Ryetechv1/ir-filter-spectrum-console/hardware/pcb/iphone16e_2s_sk6812_two_board_v0_8/DRC_STATUS.md

# DRC Status

This v0.8 PCB package was regenerated and checked with KiCad 10.

Current generated DRC status after `kicad-cli pcb drc`:

- Main controller carrier: 0 violations; 0 unconnected items.
- LED/camera head: 0 violations; 0 unconnected items.

Use the `*_GERBERS_DRC_CLEAN.zip` files for fabrication upload. Still print the board outlines at 1:1 and verify the mechanical fit in the phone case before ordering.
