Ryetechv1/ir-filter-spectrum-console/PUBLICATION.md

# Official GitHub Publication

**Project:** SW's Spectral Image Studio  
**Canonical repository:** https://github.com/Ryetechv1/ir-filter-spectrum-console  
**Published app:** https://ryetechv1.github.io/ir-filter-spectrum-console/?studio=camera&v=official-publication-2026-08-15  
**Publication page:** https://ryetechv1.github.io/ir-filter-spectrum-console/publication.html  
**Release tag:** `official-publication-2026-08-15`

This publication marks the current GitHub Pages build as the official public reference point for the browser-based spectral imaging studio. It includes the camera studio, effect presets, generated-value engine, overlay/media workflows, PRIME examples gallery, DWT isolation package, spatial recognition mesh/voxel controls, and related documentation.

## Citation

If results created with this project are shared or referenced, cite:

> Seth M. Knudson. **SW's Spectral Image Studio**. GitHub, 2026. https://github.com/Ryetechv1/ir-filter-spectrum-console

The machine-readable citation metadata is available in `CITATION.cff`.

## Rights

The project is published publicly through GitHub Pages for access and reference. All original app content, branding, gallery material, and generated publication wording are reserved to Seth M. Knudson / Supernatural World unless a separate written license is later added.

## Verification Checklist

- GitHub repository: `Ryetechv1/ir-filter-spectrum-console`
- GitHub Pages source: `docs/`
- Published app route: `/ir-filter-spectrum-console/?studio=camera`
- Citation metadata: `CITATION.cff`
- Official release tag: `official-publication-2026-08-15`
