Ryetechv1/ir-filter-spectrum-console/hardware/pcb/iphone16e_2s_sk6812_two_board_v0_4/gerbers_esp32_cam_led_head_v0_4/esp32_cam_led_head_v0_4_drill_report.txt

Drill report for esp32_cam_led_head_v0_4.kicad_pcb
Created on 2026-07-30T06:09:37

Copper Layer Stackup:
    =============================================================
    L1 :  F.Cu                      front
    L2 :  B.Cu                      back

Drill file 'esp32_cam_led_head_v0_4-PTH.drl' contains
    plated through holes:
    =============================================================
    T1  0.400mm  0.0157"  (7 holes))
    T2  0.900mm  0.0354"  (12 holes))

    Total plated holes count 19

Drill file 'esp32_cam_led_head_v0_4-NPTH.drl' contains
    unplated through holes:
    =============================================================

    Total unplated holes count 0
