Ryetechv1/ir-filter-spectrum-console/hardware/pcb/iphone16e_2s_sk6812_two_board_v0_4/gerbers_iphone16e_2s_sk6812_main_v0_4/iphone16e_2s_sk6812_main_v0_4_drill_report.txt

Drill report for iphone16e_2s_sk6812_main_v0_4.kicad_pcb
Created on 2026-07-30T06:09:34

Copper Layer Stackup:
    =============================================================
    L1 :  F.Cu                      front
    L2 :  B.Cu                      back

Drill file 'iphone16e_2s_sk6812_main_v0_4-PTH.drl' contains
    plated through holes:
    =============================================================
    T1  0.400mm  0.0157"  (24 holes))
    T2  1.000mm  0.0394"  (52 holes))
    T3  1.500mm  0.0591"  (6 holes))
    T4  2.000mm  0.0787"  (2 holes))

    Total plated holes count 84

Drill file 'iphone16e_2s_sk6812_main_v0_4-NPTH.drl' contains
    unplated through holes:
    =============================================================
    T1  3.200mm  0.1260"  (3 holes))

    Total unplated holes count 3
