Ryetechv1/ir-filter-spectrum-console/design/esp32-cam-ir-uva-console-concept.png

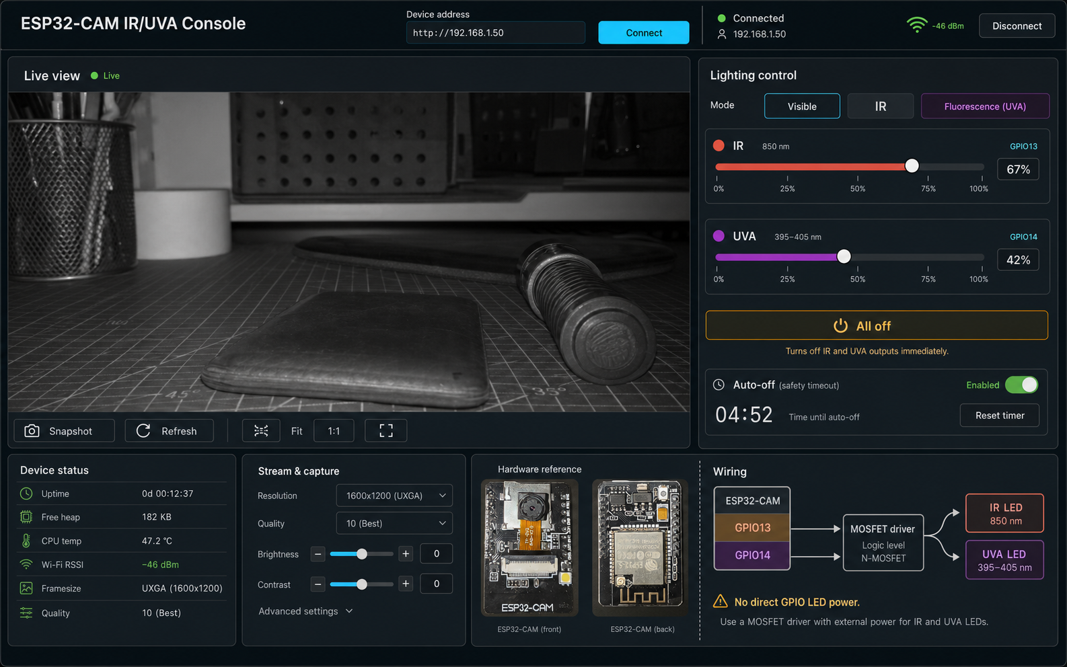
design/esp32-cam-ir-uva-console-concept.png
