Ryetechv1/ir-filter-spectrum-console/integrations/dwt_isolate_pipeline/exports/comparison_matrix_plot.png

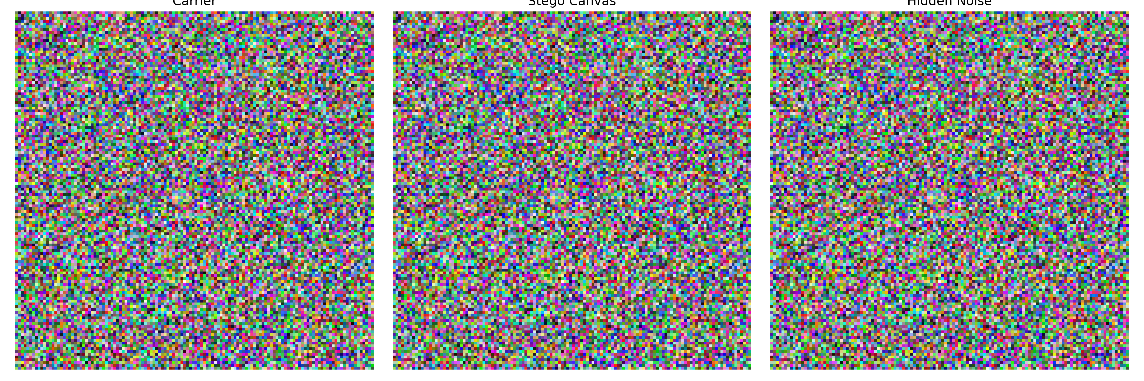
integrations/dwt_isolate_pipeline/exports/comparison_matrix_plot.png
