Ryetechv1/ir-filter-spectrum-console/integrations/dwt_isolate_pipeline/exports/export_extracted_hidden_noise.png

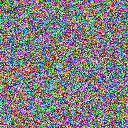
integrations/dwt_isolate_pipeline/exports/export_extracted_hidden_noise.png
