Ryetechv1/ir-filter-spectrum-console/hardware/pcb/iphone16e_2s_sk6812_two_board_v0_8/README_ORDERING.md

# iPhone 16e 2S SK6812 Two-Board PCB v0.8

This package contains two separate 2-layer KiCad PCB designs:

- Main controller carrier: `iphone16e_2s_sk6812_main_v0_8.kicad_pcb`
- Compact LED/camera head: `esp32_cam_led_head_v0_8.kicad_pcb`

The included v0.8 Gerber zip packages were regenerated with KiCad 10 and checked with DRC.

## What Changed From v0.7

- Added six SK6812 5 mm RGBW LEDs to the LED/camera head board for three independently controlled acrylic-square zones.
- Each acrylic zone has one left-edge LED and one right-edge LED driven as a mirrored pair from one webapp RGBW control.
- Expanded the head board to 50 mm x 90 mm while keeping it inside the 58 mm camera chamber envelope.
- Kept the same 14-pin JST-GH 1.25 mm locking wire-harness connector and the same single SK6812 data line.

## Power Compatibility

This is still optimized for the selected OVONIC 2S 7.4V 450mAh LiPo pack.

Use a proper 2S/8.4V USB-C LiPo charger/BMS plus a 2S-to-5V buck regulator rated 1A minimum, 2A preferred.

Do not use the 3S/12.6V Adeept charger module with this 2S battery.

## Suggested Fab Settings

- 2 layers for each board
- FR-4, 1.6 mm for the main board
- FR-4, 0.8 mm or 1.0 mm recommended for the LED head if your shell needs a lower profile
- 1 oz copper acceptable for this low-current LED version, 2 oz preferred
- Lead-free HASL or ENIG

## Important Assembly Checks

- Verify JST-GH harness pin 1 to pin 1 before powering the boards. Use a straight-through 14-conductor crimped harness.
- Verify the SK6812 5 mm RGBW LED pinout from your exact vendor before PCBA ordering. The generated footprint maps pin 1 to +5V, pin 2 to DIN, pin 3 to GND, and pin 4 to DOUT.
- The SK6812 chain order is RGBW 1 camera right, RGBW 2 camera left, Acrylic 1 left, Acrylic 1 right, Acrylic 2 left, Acrylic 2 right, Acrylic 3 left, Acrylic 3 right.
- Print both PCB outlines at 1:1 and test-fit them in the Speck case and printed shell before ordering.
- UVA and IR are eye hazards. Use shielding and UV-rated eye protection.
