Ryetechv1/ir-filter-spectrum-console/hardware/cad/iphone16e_housing_v0_1/stl/02_main_board_retainer.stl

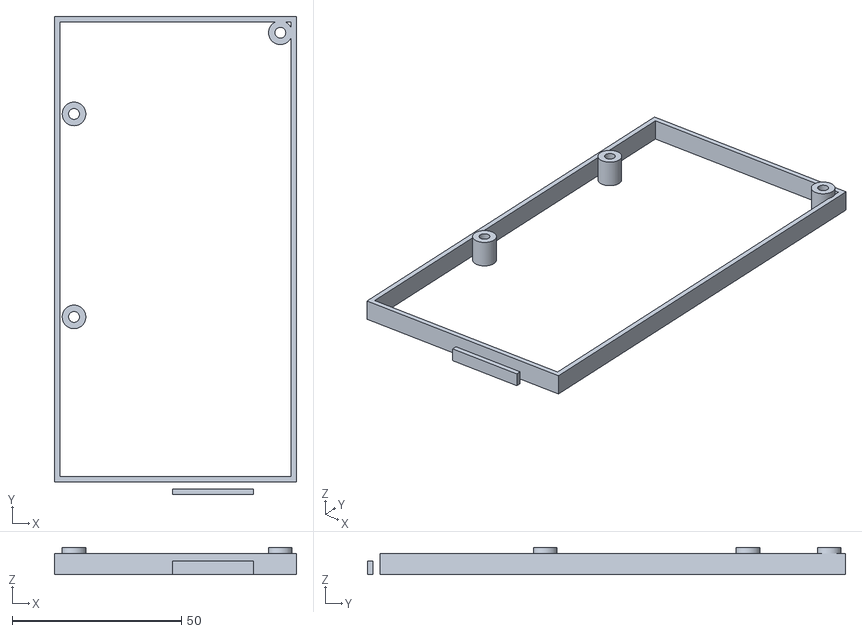
[picture p19: CAD file, 2026-08-01]
hardware/cad/iphone16e_housing_v0_1/stl/02_main_board_retainer.stl
71.6 x 141.3 x 8.00
