Ryetechv1/ir-filter-spectrum-console/hardware/cad/iphone16e_housing_v0_1/stl/08_acrylic_square_1_template.stl

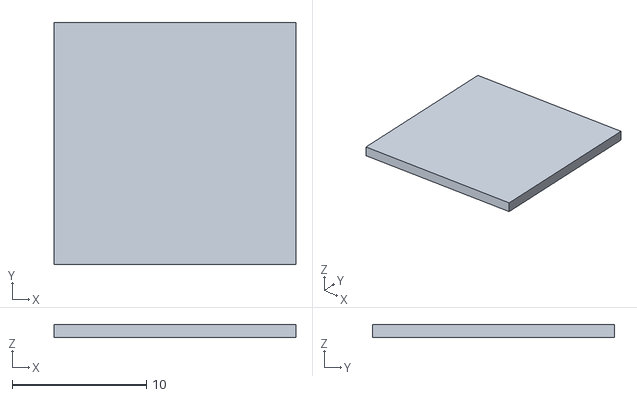
[picture p20: CAD file, 2026-08-01]
hardware/cad/iphone16e_housing_v0_1/stl/08_acrylic_square_1_template.stl
18.0 x 18.0 x 1.00
