Ryetechv1/ir-filter-spectrum-console/hardware/cad/iphone16e_housing_v0_1/stl/01_phone_back_sled.stl

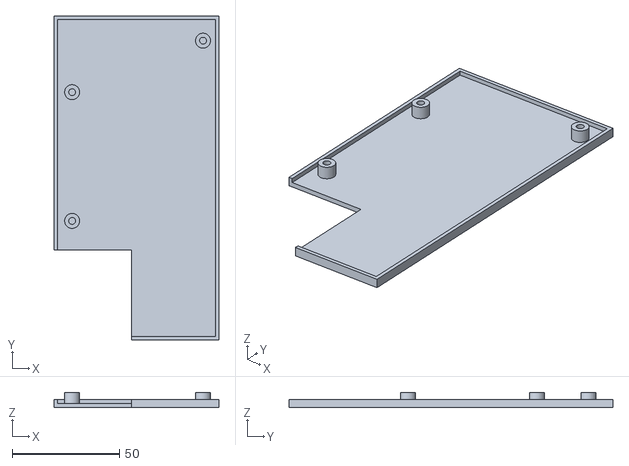
[picture p21: CAD file, 2026-08-01]
hardware/cad/iphone16e_housing_v0_1/stl/01_phone_back_sled.stl
76.8 x 151.0 x 7.20
