Ryetechv1/ir-filter-spectrum-console/hardware/cad/iphone16e_housing_v0_1/stl/06_clear_acrylic_lens_panel_template.stl

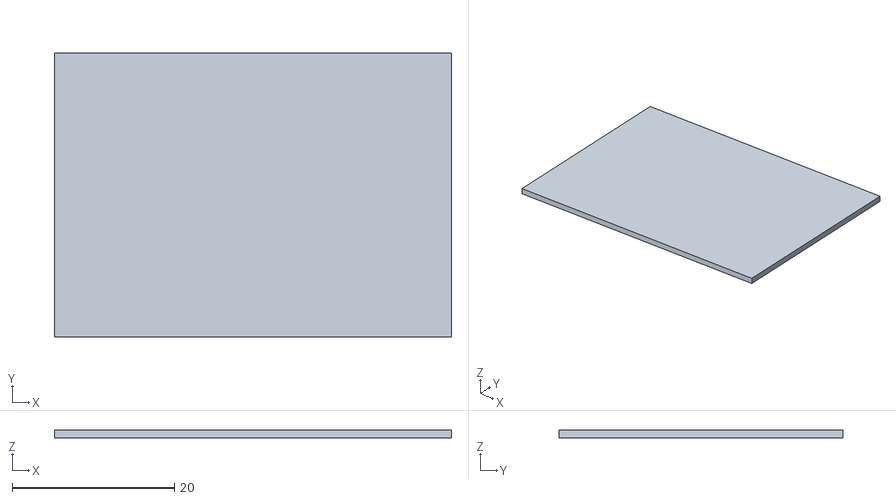
[picture p22: CAD file, 2026-08-01]
hardware/cad/iphone16e_housing_v0_1/stl/06_clear_acrylic_lens_panel_template.stl
49.0 x 35.0 x 1.00
