Ryetechv1/ir-filter-spectrum-console/hardware/cad/iphone16e_housing_v0_1/stl/03_ovonic_2s_battery_cradle.stl

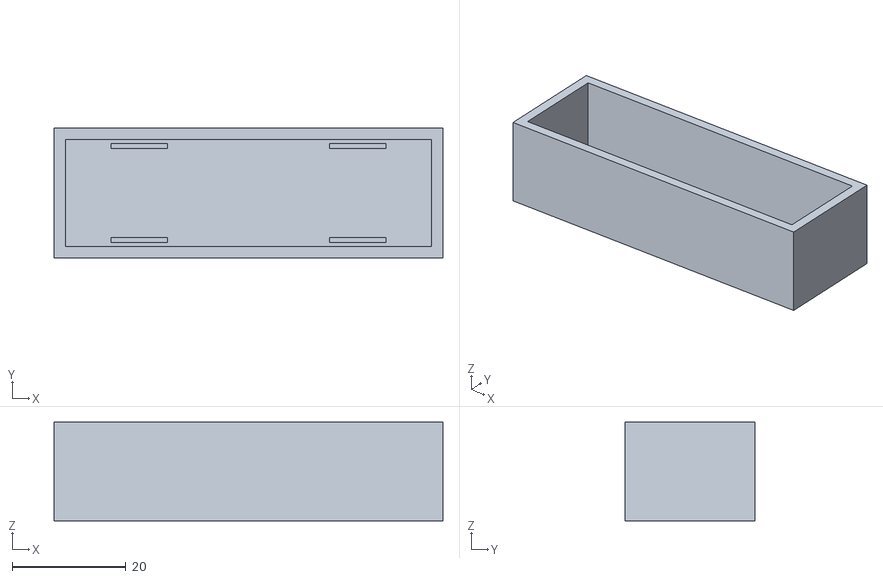
[picture p23: CAD file, 2026-08-01]
hardware/cad/iphone16e_housing_v0_1/stl/03_ovonic_2s_battery_cradle.stl
68.5 x 22.9 x 17.4
