Ryetechv1/ir-filter-spectrum-console/hardware/cad/iphone16e_housing_v0_1/stl/04_head_board_camera_effect_chamber.stl

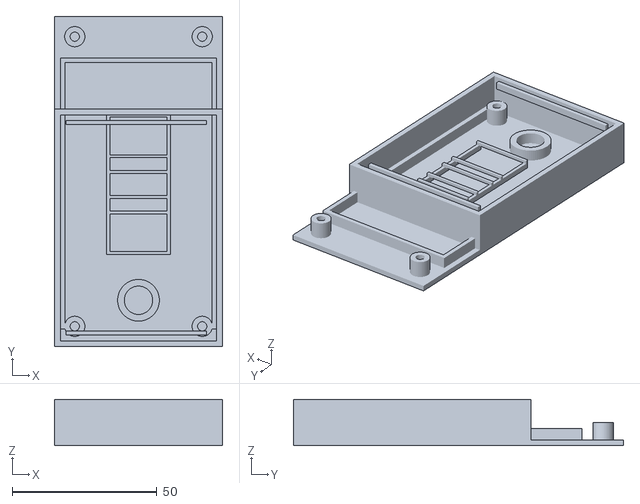
[picture p24: CAD file, 2026-08-01]
hardware/cad/iphone16e_housing_v0_1/stl/04_head_board_camera_effect_chamber.stl
58.0 x 114.0 x 16.1
