Ryetechv1/ir-filter-spectrum-console/hardware/cad/iphone16e_housing_v0_1/stl/00_housing_all_parts_preview.stl

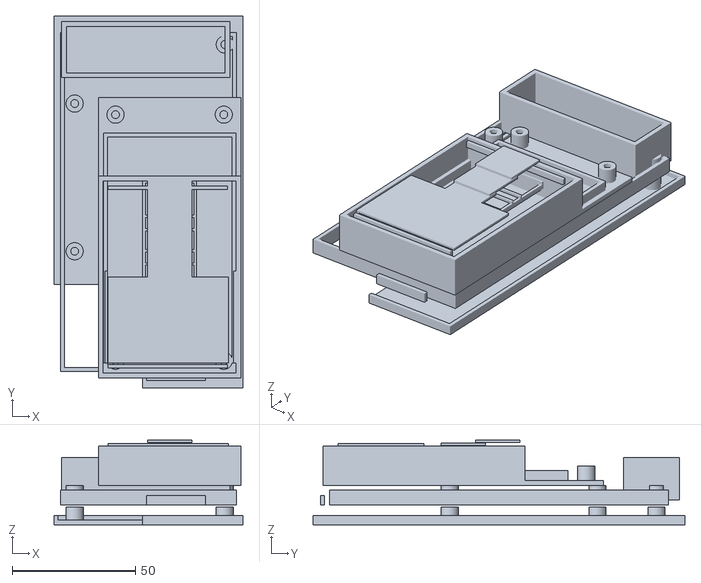
[picture p25: CAD file, 2026-08-01]
hardware/cad/iphone16e_housing_v0_1/stl/00_housing_all_parts_preview.stl
76.8 x 151.0 x 34.4
