Ryetechv1/ir-filter-spectrum-console/hardware/cad/iphone16e_housing_v0_1/stl/07_right_reflective_insert.stl

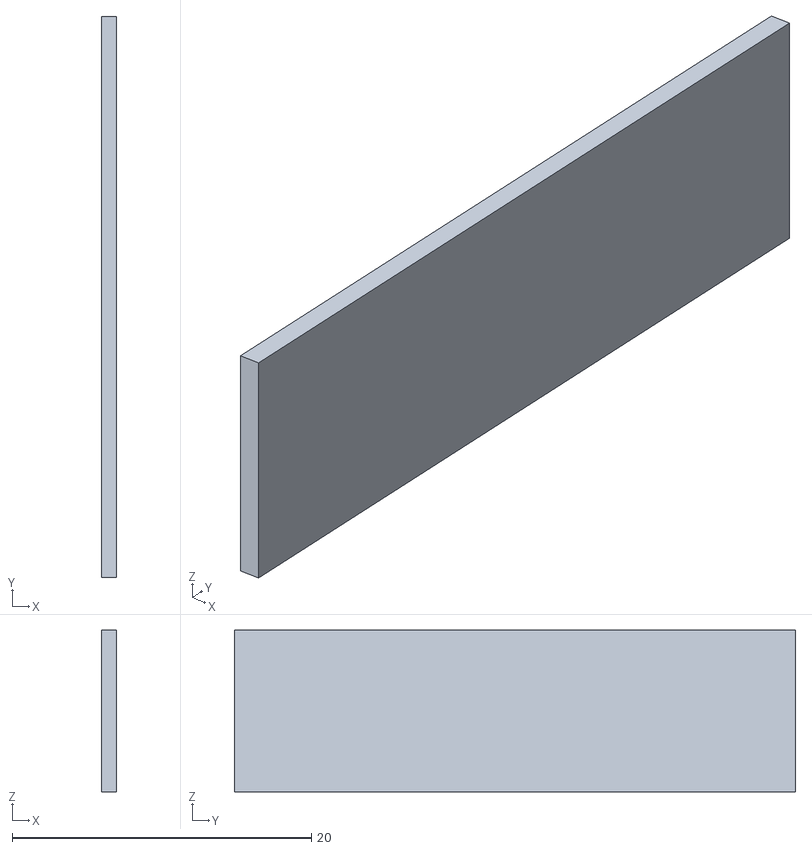
[picture p26: CAD file, 2026-08-01]
hardware/cad/iphone16e_housing_v0_1/stl/07_right_reflective_insert.stl
1.00 x 37.5 x 10.8
