Ryetechv1/ir-filter-spectrum-console/(list of files, cad)

Other CAD files:
hardware/cad/iphone16e_housing_v0_1/stl/10_acrylic_square_3_template.stl
hardware/cad/iphone16e_housing_v0_1/stl/09_acrylic_square_2_template.stl
hardware/cad/iphone16e_housing_v0_1/stl/07_left_reflective_insert.stl
