Ryetechv1/ir-filter-spectrum-console/hardware/pcb/iphone16e_2s_sk6812_two_board_v0_6/iphone16e_2s_sk6812_main_v0_6.kicad_pcb

## KiCad design hardware/pcb/iphone16e_2s_sk6812_two_board_v0_6/iphone16e_2s_sk6812_main_v0_6.kicad_pcb (2026-08-01, an earlier design)

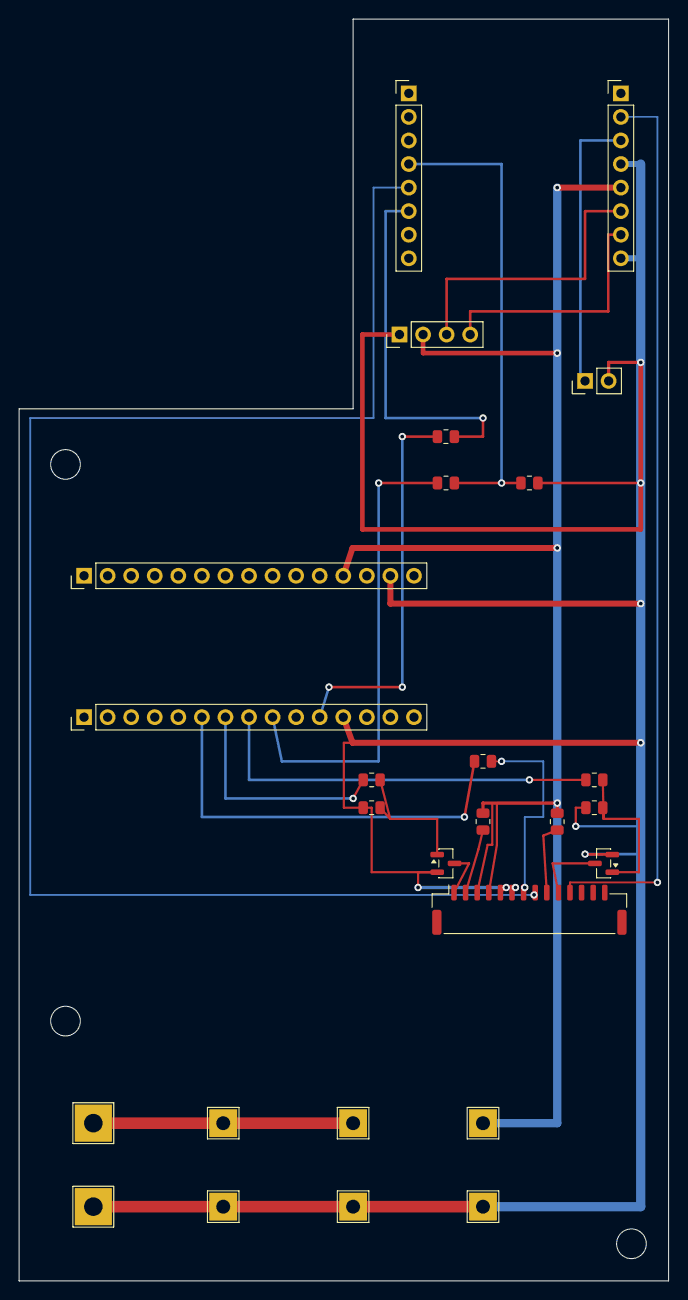
[picture p27: board iphone16e_2s_sk6812_main_v0_6.kicad_pcb from above]

Board: 2 copper layers, 70.0 x 136.0 mm, 30 parts (0 on the bottom side), 22 nets.

Parts:
H1, H2, H3: mount; MountingHole_3.2mm_M3
J1: ESP32-CAM LEFT; PinHeader_1x08_P2.54mm_Vertical
J2: ESP32-CAM RIGHT; PinHeader_1x08_P2.54mm_Vertical
J3: USB-UART; PinHeader_1x04_P2.54mm_Vertical
J4: NANO LEFT ROW; PinHeader_1x15_P2.54mm_Vertical
J5: NANO RIGHT ROW; PinHeader_1x15_P2.54mm_Vertical
J8: LED HEAD JST-GH; JST_GH_SM14B-GHS-TB_1x14-1MP_P1.25mm_Horizontal
JP1: BOOT; PinHeader_1x02_P2.54mm_Vertical
P1: 2S PACK +; TestPoint_THTPad_4.0x4.0mm_Drill2.0mm
P2: PACK -; TestPoint_THTPad_4.0x4.0mm_Drill2.0mm
P3: 2S CHG +; TestPoint_THTPad_3.0x3.0mm_Drill1.5mm
P4: 2S CHG -; TestPoint_THTPad_3.0x3.0mm_Drill1.5mm
P5: BUCK IN +; TestPoint_THTPad_3.0x3.0mm_Drill1.5mm
P6: BUCK IN -; TestPoint_THTPad_3.0x3.0mm_Drill1.5mm
P7: 5V SYS +; TestPoint_THTPad_3.0x3.0mm_Drill1.5mm
P8: 5V SYS -; TestPoint_THTPad_3.0x3.0mm_Drill1.5mm
Q1: AO3400A IR; SOT-23
Q2: AO3400A UVA; SOT-23
R1: 100R 0.25W; R_0805_2012Metric
R2, R5: 150R; R_0805_2012Metric
R3, R6: 100k; R_0805_2012Metric
R4: 68R 0.25W; R_0805_2012Metric
R7: 330R; R_0805_2012Metric
R8: 1k; R_0805_2012Metric
R9: 2k; R_0805_2012Metric
R10: 470R; R_0805_2012Metric

Connections:
+5V_SYS: J2.5, J3.2, J4.12, J8.3, J8.4, P7.1, R1.1, R4.1
ESP_GPIO13_RX: J1.4, R8.2, R9.1
ESP_GPIO14_TX: J1.6, R10.2
ESP_GPIO15_GLASS_SDA: J1.5, J8.8
ESP_GPIO16_GLASS_SCL: J2.2, J8.11
ESP_IO0_BOOT: J2.3, JP1.1
ESP_U0R_PROG: J2.6, J3.3
ESP_U0T_PROG: J2.7, J3.4
GND: J2.4, J2.8, J3.1, J4.14, J5.12, J8.5, J8.6, JP1.2, P2.1, P4.1, P6.1, P8.1, Q1.2, Q2.2, R3.1, R6.1, R9.2
IR_ANODE: J8.9, R1.2
IR_GATE: Q1.1, R2.2, R3.2
IR_NEG: J8.10, Q1.3
NANO_D2_RX: J5.11, R10.1
NANO_D4_TX: J5.9, R8.1
NANO_D5_IR_PWM: J5.8, R2.1
NANO_D6_UVA_PWM: J5.7, R5.1
NANO_D7_SK6812_DATA: J5.6, R7.1
SK6812_DIN_1: J8.7, R7.2
UVA_ANODE: J8.2, R4.2
UVA_GATE: Q2.1, R5.2, R6.2
UVA_NEG: J8.1, Q2.3
VBAT_2S: P1.1, P3.1, P5.1
