Ryetechv1/ir-filter-spectrum-console/hardware/pcb/iphone16e_2s_sk6812_two_board_v0_8/esp32_cam_led_head_v0_8.kicad_pcb

## KiCad design hardware/pcb/iphone16e_2s_sk6812_two_board_v0_8/esp32_cam_led_head_v0_8.kicad_pcb (2026-08-01)

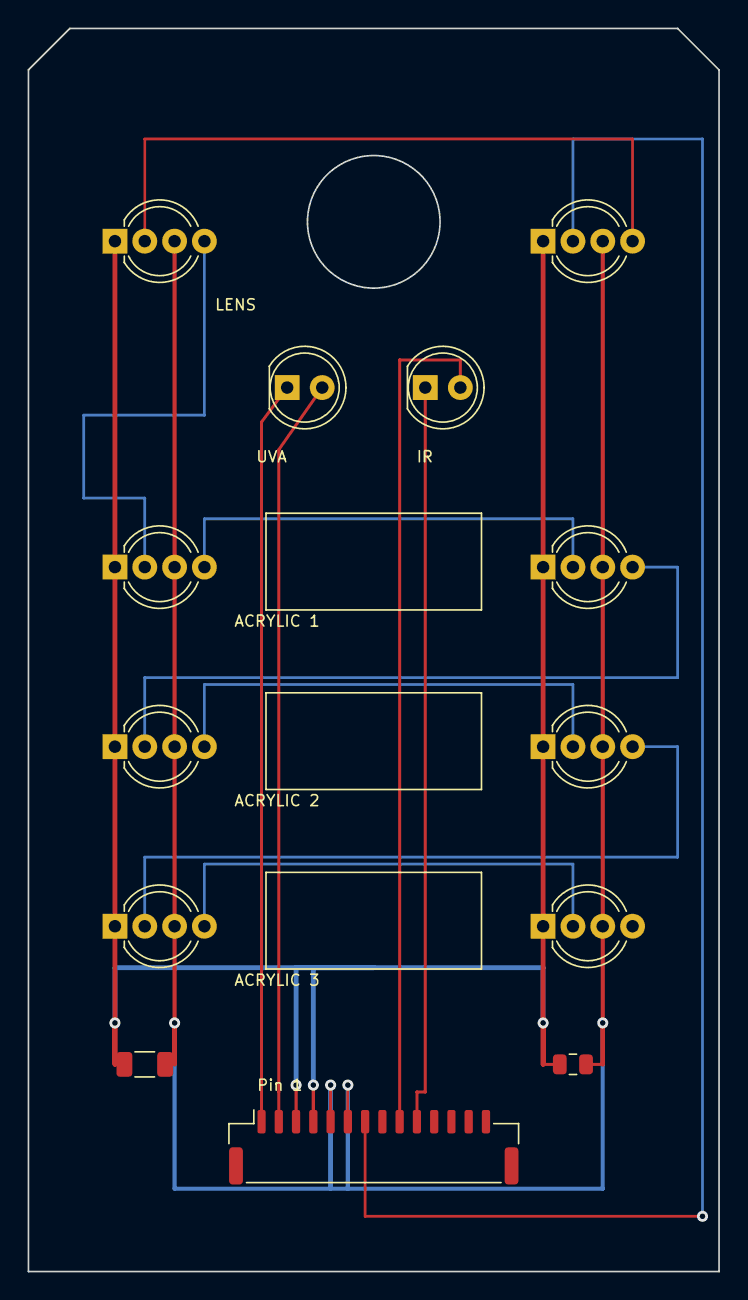
[picture p28: board esp32_cam_led_head_v0_8.kicad_pcb from above]

Board: 2 copper layers, 50.0 x 90.0 mm, 13 parts (0 on the bottom side), 14 nets.

Parts:
C1: 47uF-100uF; C_1206_3216Metric
C2: 0.1uF; C_0805_2012Metric
D1: 950nm IR; LED_D5.0mm_IRBlack
D2: 375nm UVA; LED_D5.0mm_Clear
D3: RGBW 1 RIGHT; LED_D5.0mm-4_RGB_Wide_Pins
D4: RGBW 2 LEFT; LED_D5.0mm-4_RGB_Wide_Pins
D5: ACRYLIC 1 LEFT; LED_D5.0mm-4_RGB_Wide_Pins
D6: ACRYLIC 1 RIGHT; LED_D5.0mm-4_RGB_Wide_Pins
D7: ACRYLIC 2 LEFT; LED_D5.0mm-4_RGB_Wide_Pins
D8: ACRYLIC 2 RIGHT; LED_D5.0mm-4_RGB_Wide_Pins
D9: ACRYLIC 3 LEFT; LED_D5.0mm-4_RGB_Wide_Pins
D10: ACRYLIC 3 RIGHT; LED_D5.0mm-4_RGB_Wide_Pins
J1: 14P JST-GH TO MAIN; JST_GH_SM14B-GHS-TB_1x14-1MP_P1.25mm_Horizontal

Connections:
+5V_LED: C1.1, C2.1, D3.1, D4.1, D5.1, D6.1, D7.1, D8.1, D9.1, D10.1, J1.3, J1.4
GND: C1.2, C2.2, D3.3, D4.3, D5.3, D6.3, D7.3, D8.3, D9.3, D10.3, J1.5, J1.6
IR_ANODE: D1.2, J1.9
IR_NEG: D1.1, J1.10
SK6812_1_TO_2: D3.4, D4.2
SK6812_2_TO_3: D4.4, D5.2
SK6812_3_TO_4: D5.4, D6.2
SK6812_4_TO_5: D6.4, D7.2
SK6812_5_TO_6: D7.4, D8.2
SK6812_6_TO_7: D8.4, D9.2
SK6812_7_TO_8: D9.4, D10.2
SK6812_DIN_1: D3.2, J1.7
UVA_ANODE: D2.2, J1.2
UVA_NEG: D2.1, J1.1
