Ryetechv1/ir-filter-spectrum-console/(commit log)

2026-08-01 Publish IR filter console
    [00_housing_all_parts_preview.stl, 01_phone_back_sled.stl, 02_main_board_retainer.stl, 03_ovonic_2s_battery_cradle.stl, 04_head_board_camera_effect_chamber.stl, 06_clear_acrylic_lens_panel_template.stl, 07_left_reflective_insert.stl, 07_right_reflective_insert.stl]
2026-08-01 Swap Nano driver for ESP32 LCD board
    [esp32_c6_hologram_prototype_01.ino, esp32_c6_hologram_prototype_02.ino, esp32_c6_hologram_prototype_03.ino, esp32_c6_hologram_prototype_04.ino, esp32_c6_hologram_prototype_05.ino, esp32_cam_ir_uv_webapp.ino, esp32_cam_prototype_01.ino, esp32_cam_prototype_02.ino]
2026-08-01 Add local camera studio
2026-08-01 Add explicit camera start stop controls
2026-08-01 Add advanced camera studio controls
2026-08-01 Update camera studio access and recording
2026-08-01 Add selective camera layer editing
2026-08-01 Add smart camera recognition selection
2026-08-01 Add floating camera HUD
2026-08-01 Fix camera studio sliders and brush ROI
2026-08-01 Remove selective camera recognition studio
2026-08-01 Restore working camera studio filters
2026-08-01 Add rear camera flashlight toggle
2026-08-01 Expand camera inversion controls and grouped adjustments
2026-08-01 Align camera snapshots with live studio filters
2026-08-02 Add synced floating camera HUD
2026-08-02 Fix camera snapshot preview export
2026-08-02 Add thermal camera modes and exact preview snapshots
2026-08-02 Expand thermal modes and tune camera rendering
2026-08-02 Fix thermal camera artifacts
2026-08-02 Add camera media compositor
2026-08-02 Add equation filter engine
2026-08-03 Improve camera studio performance
2026-08-03 Clean up floating camera HUD
2026-08-03 Amplify camera studio effects
2026-08-03 Fix camera snapshot export preview match
2026-08-03 Make camera exports clean
2026-08-12 Update camera studio access code and smart signals
2026-08-12 Amplify camera effect presets
2026-08-12 Fix mobile camera studio layout
2026-08-12 Fix camera preset updates and remove vignette
2026-08-12 Sync mobile camera HUD preview
2026-08-12 Sync mobile camera render with desktop preview
2026-08-13 Restore camera flashlight toggle
2026-08-13 Add live point cloud TIN camera mapping
2026-08-13 Sync spatial recognition across camera sides
2026-08-13 Fix spatial power and parallax drift
2026-08-13 Sync spatial cell mapping with live frame field
2026-10-05 Remove Wi-Fi credentials from published camera sketch
